cactorium/ism-915mhz-transceiver/sim/README.md

Basically a lot of simulations used for designing different stages of the discrete transceiver.
It's an agglomeration of Qucs simulations with Jupyter notebooks, so you'll want those two programs to examine this stuff
