cactorium/ism-915mhz-transceiver/pcb/discrete/discrete-rf-board/pdfs/discrete-rf-board.pdf

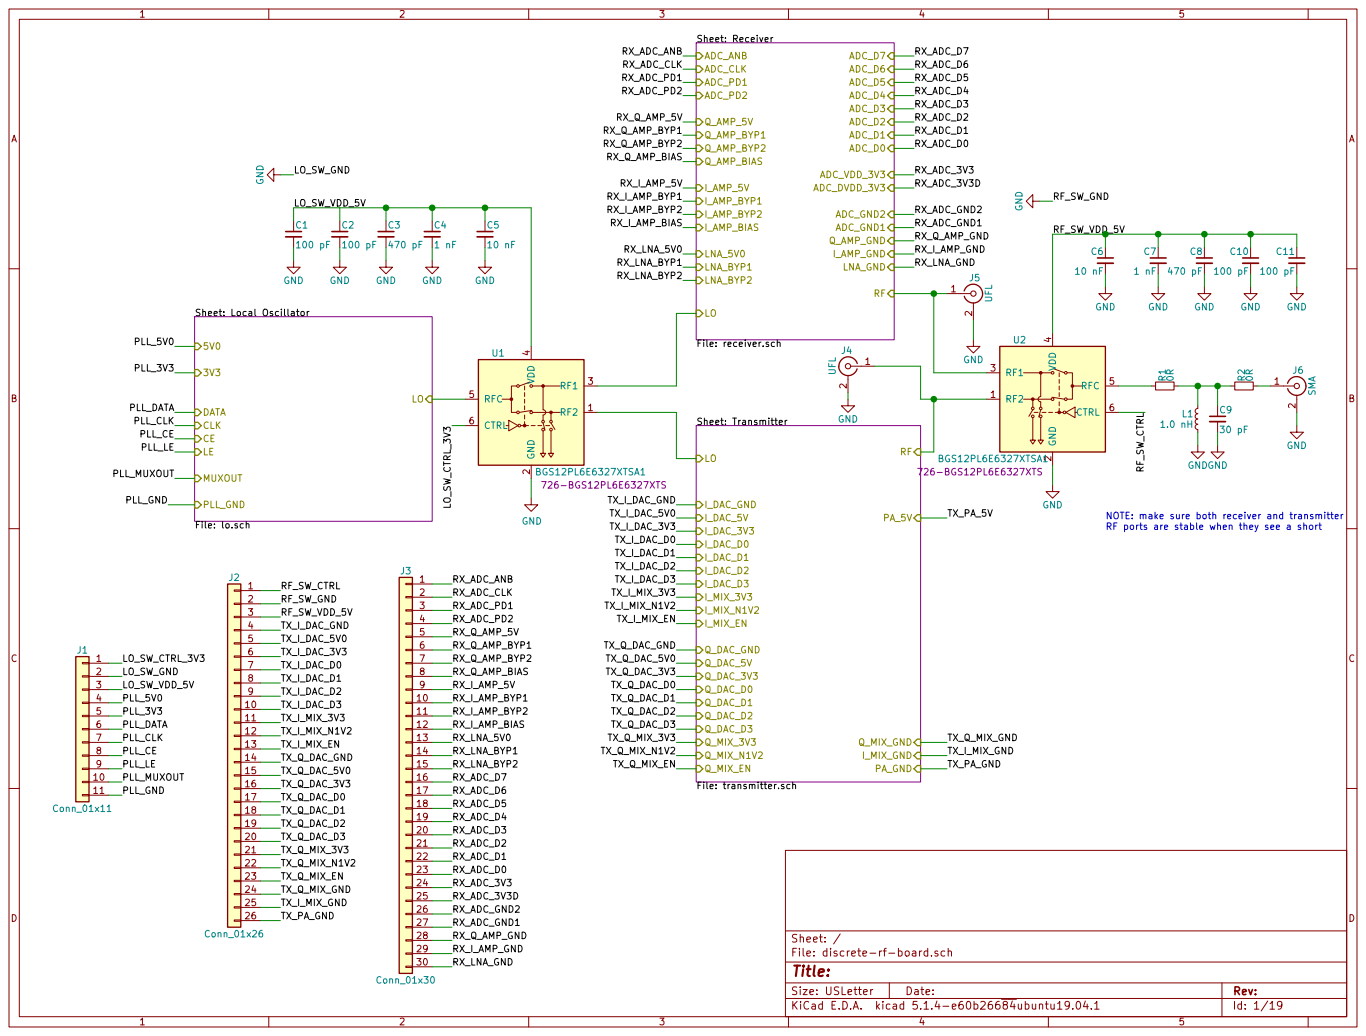
[picture p1: page 1]

Sheet: Local Oscillator File: lo.sch CLK CEMUXOUT

Id: 1/19 Title: File: discrete-rf-board.sch Sheet: /

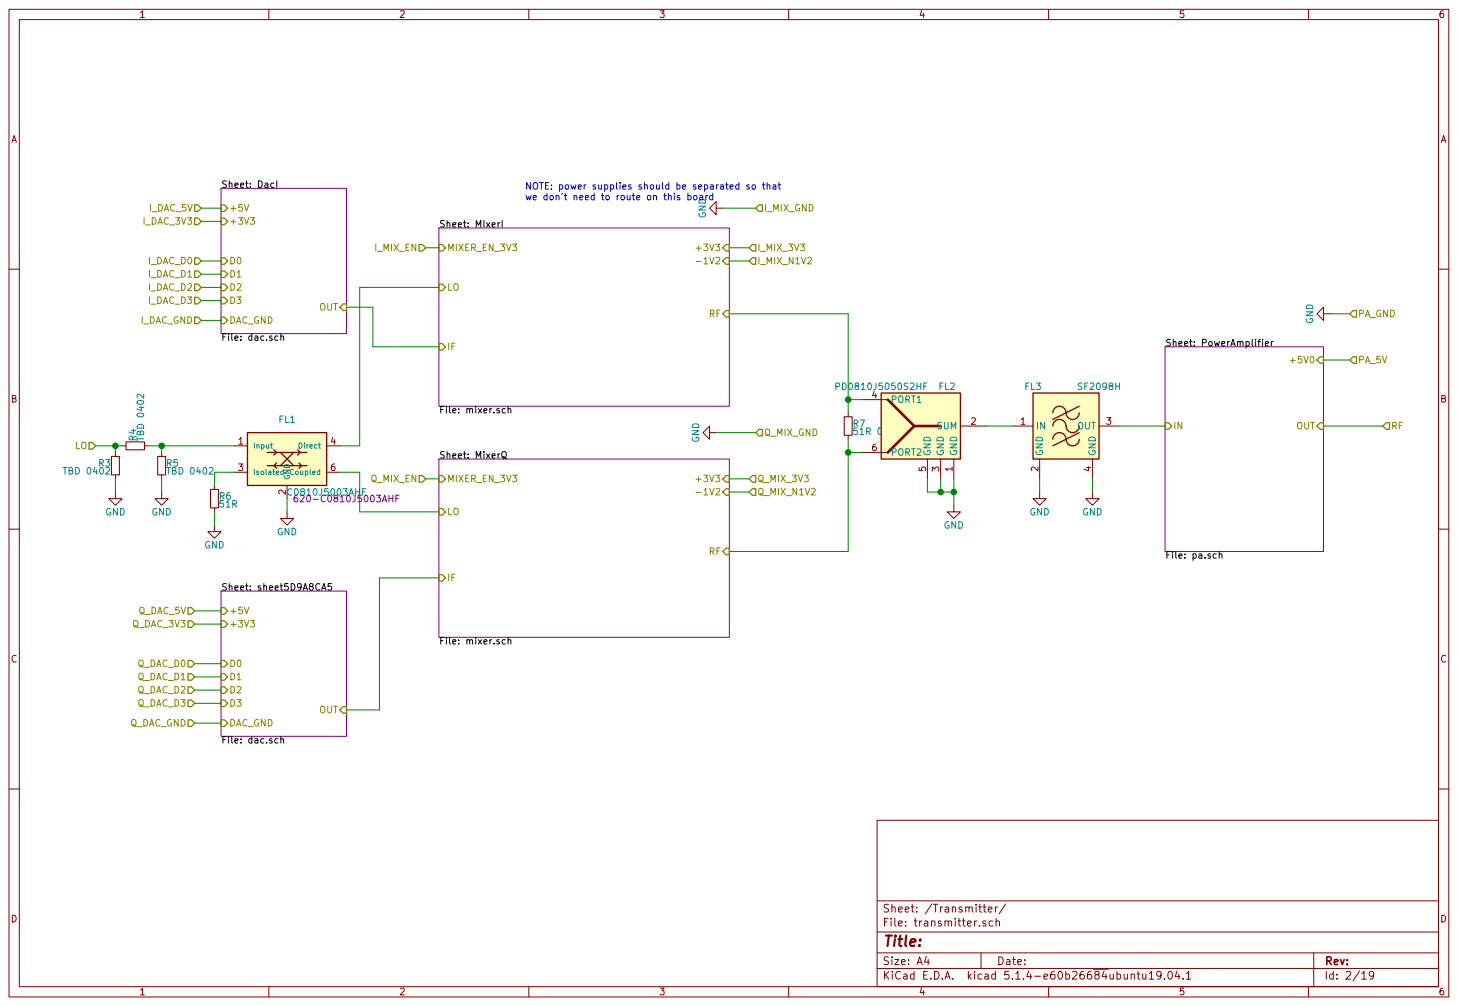
[picture p2: page 2]

+5V0 Sheet: MIxerI File: mixer.sch
I_MIX_EN Q_MIX_EN

Id: 2/19 Title: File: transmitter.sch Sheet: /Transmitter/

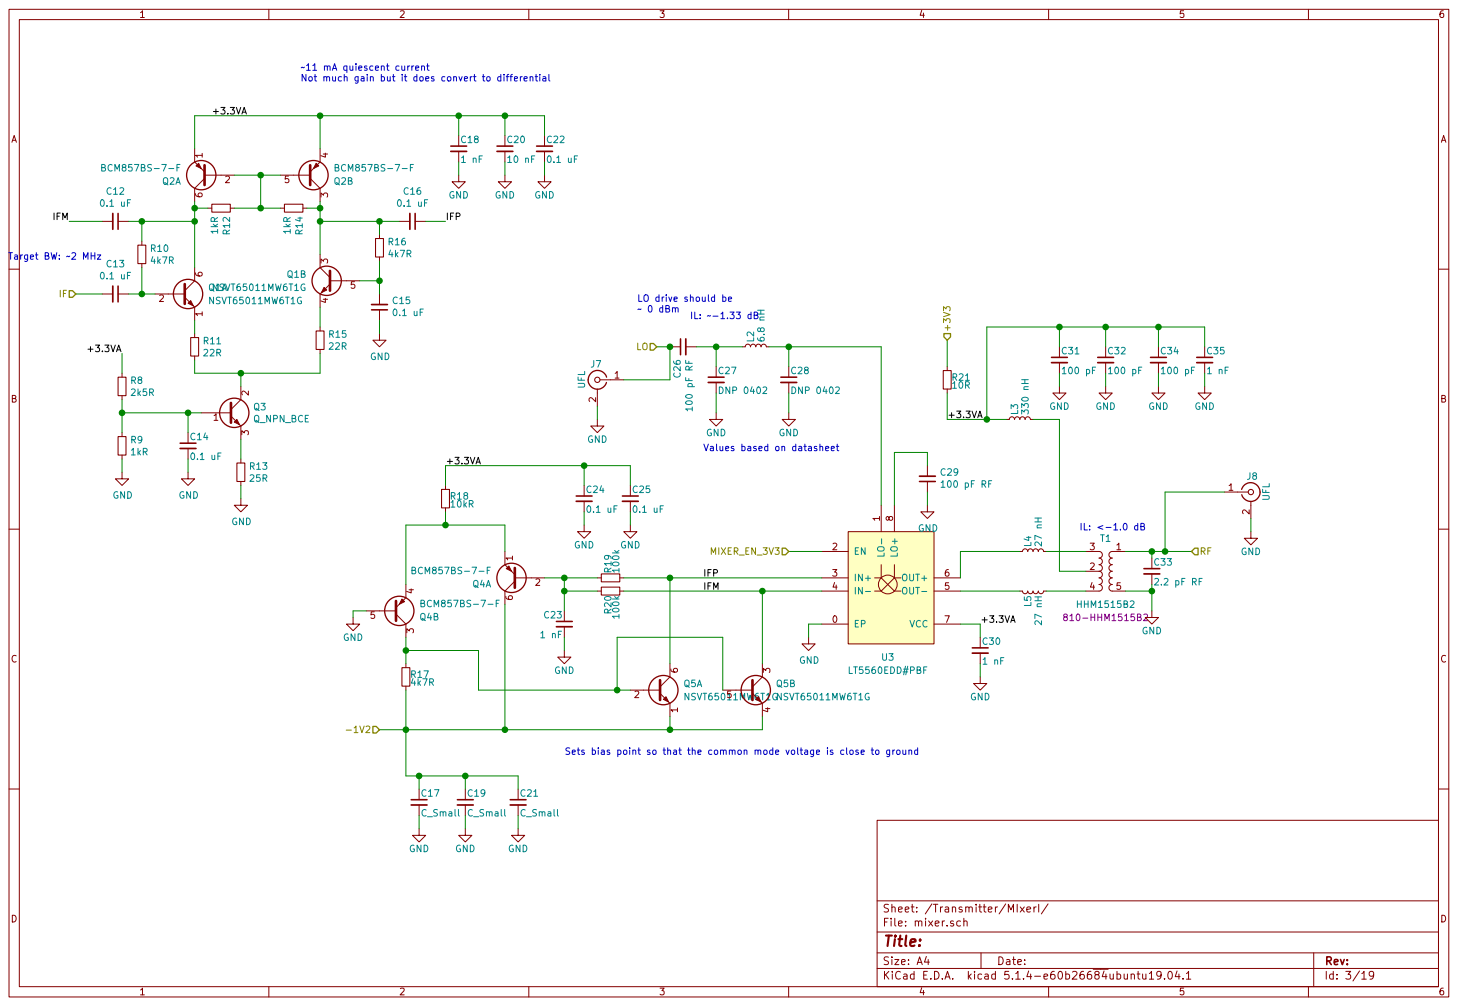
[picture p3: page 3]

LO drive should be

2 J8 UFL EP 0 LO- 1 EN 2

Sets bias point so that the common mode voltage is close to ground

Id: 3/19 Title: File: mixer.sch Sheet: /Transmitter/MIxerI/

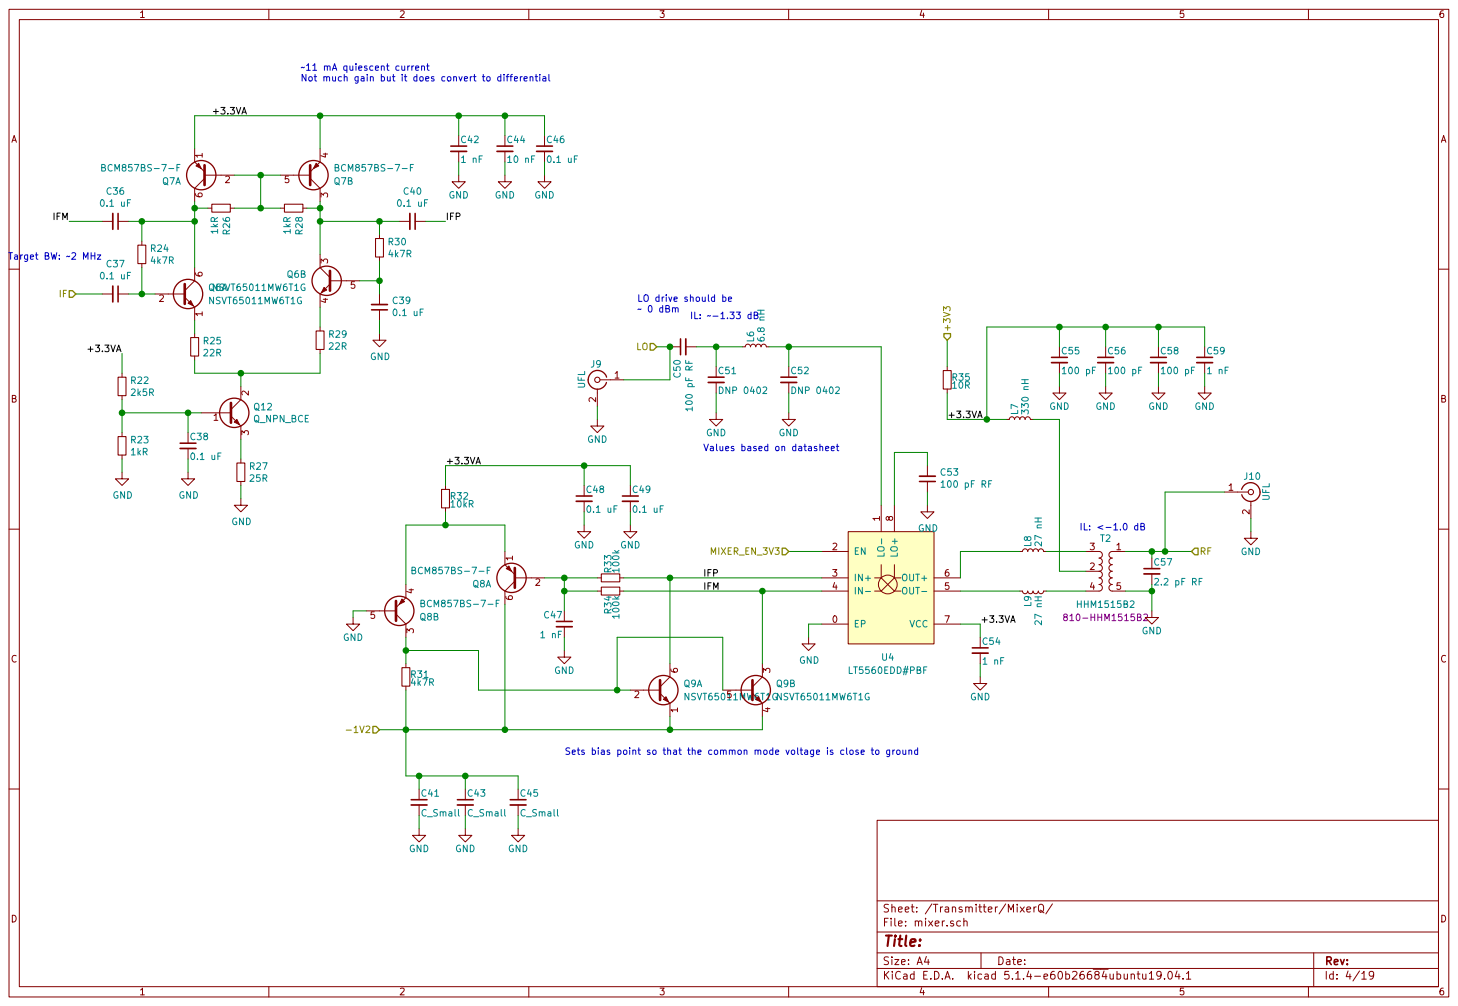
[picture p4: page 4]

LO drive should be

Sets bias point so that the common mode voltage is close to ground

Id: 4/19 Title: File: mixer.sch Sheet: /Transmitter/MixerQ/

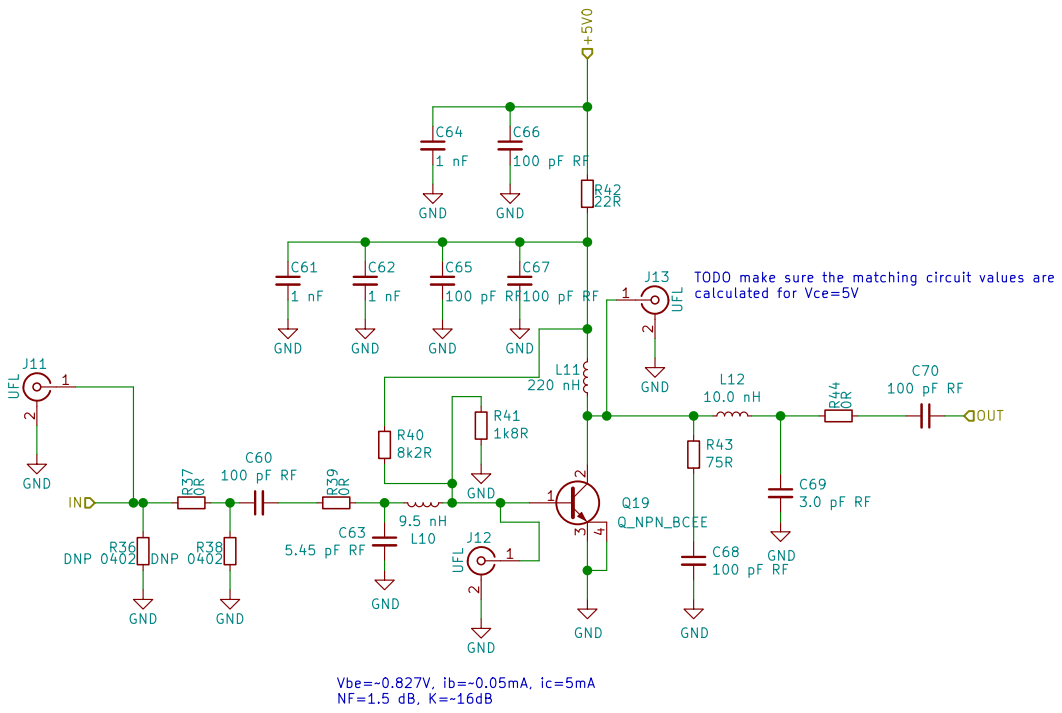
[picture p5: page 5]

J13 UFL
TODO make sure the matching circuit values are
calculated for Vce=5V

Vbe=0.827V, ib=0.05mA, ic=5mA NF=1.5 dB, K=16dB

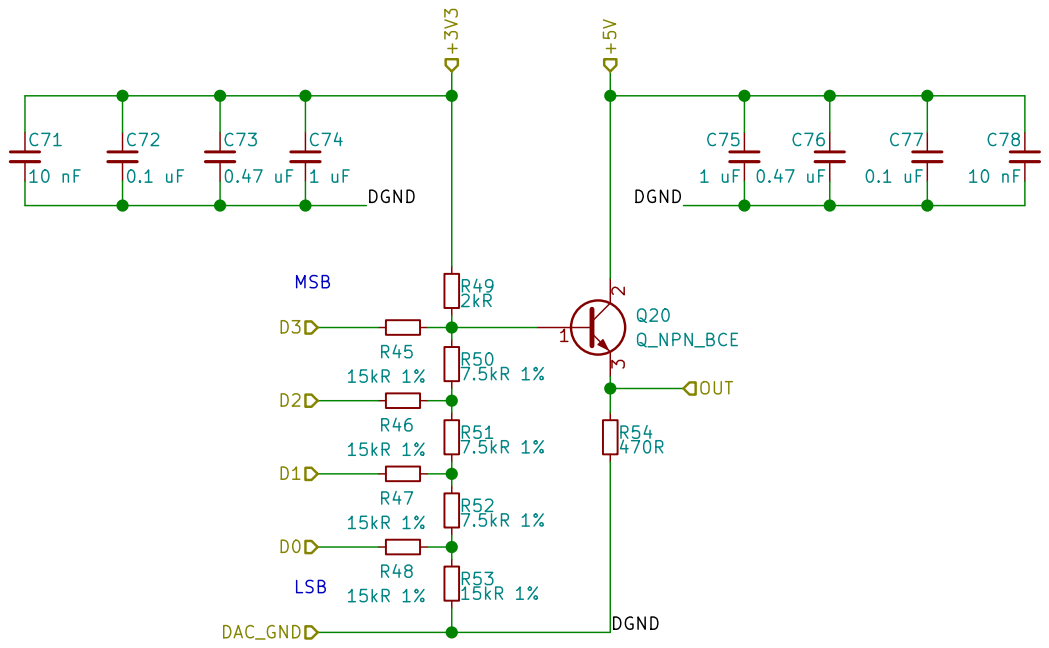
[picture p6: page 6]

Id: 6/19 Title: File: dac.sch Sheet: /Transmitter/DacI/

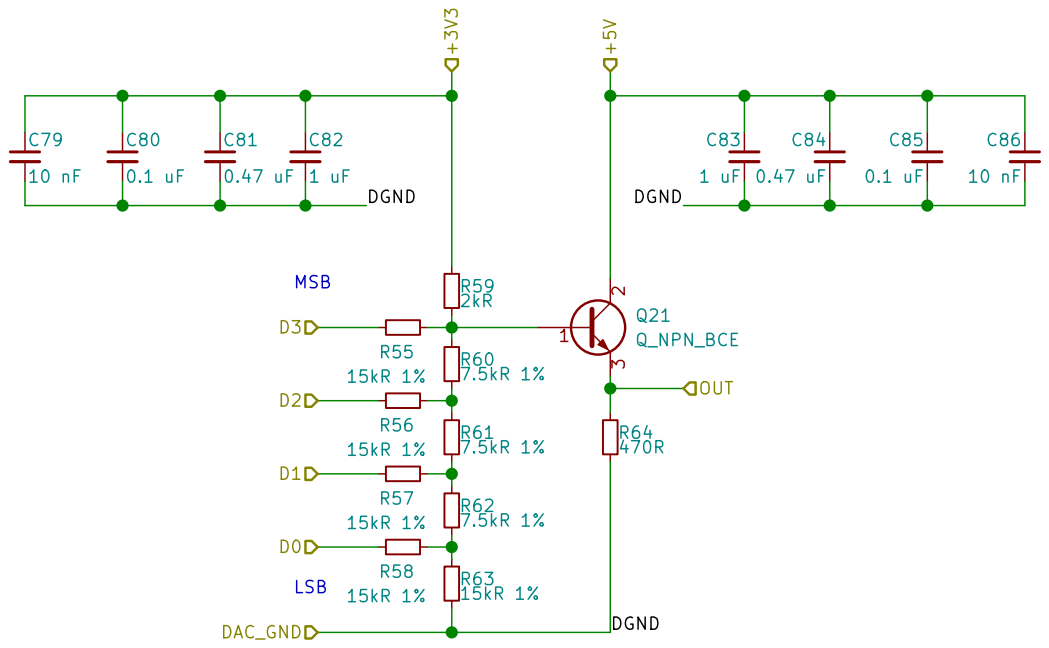
[picture p7: page 7]

Id: 7/19 Title: File: dac.sch Sheet: /Transmitter/sheet5D9A8CA5/

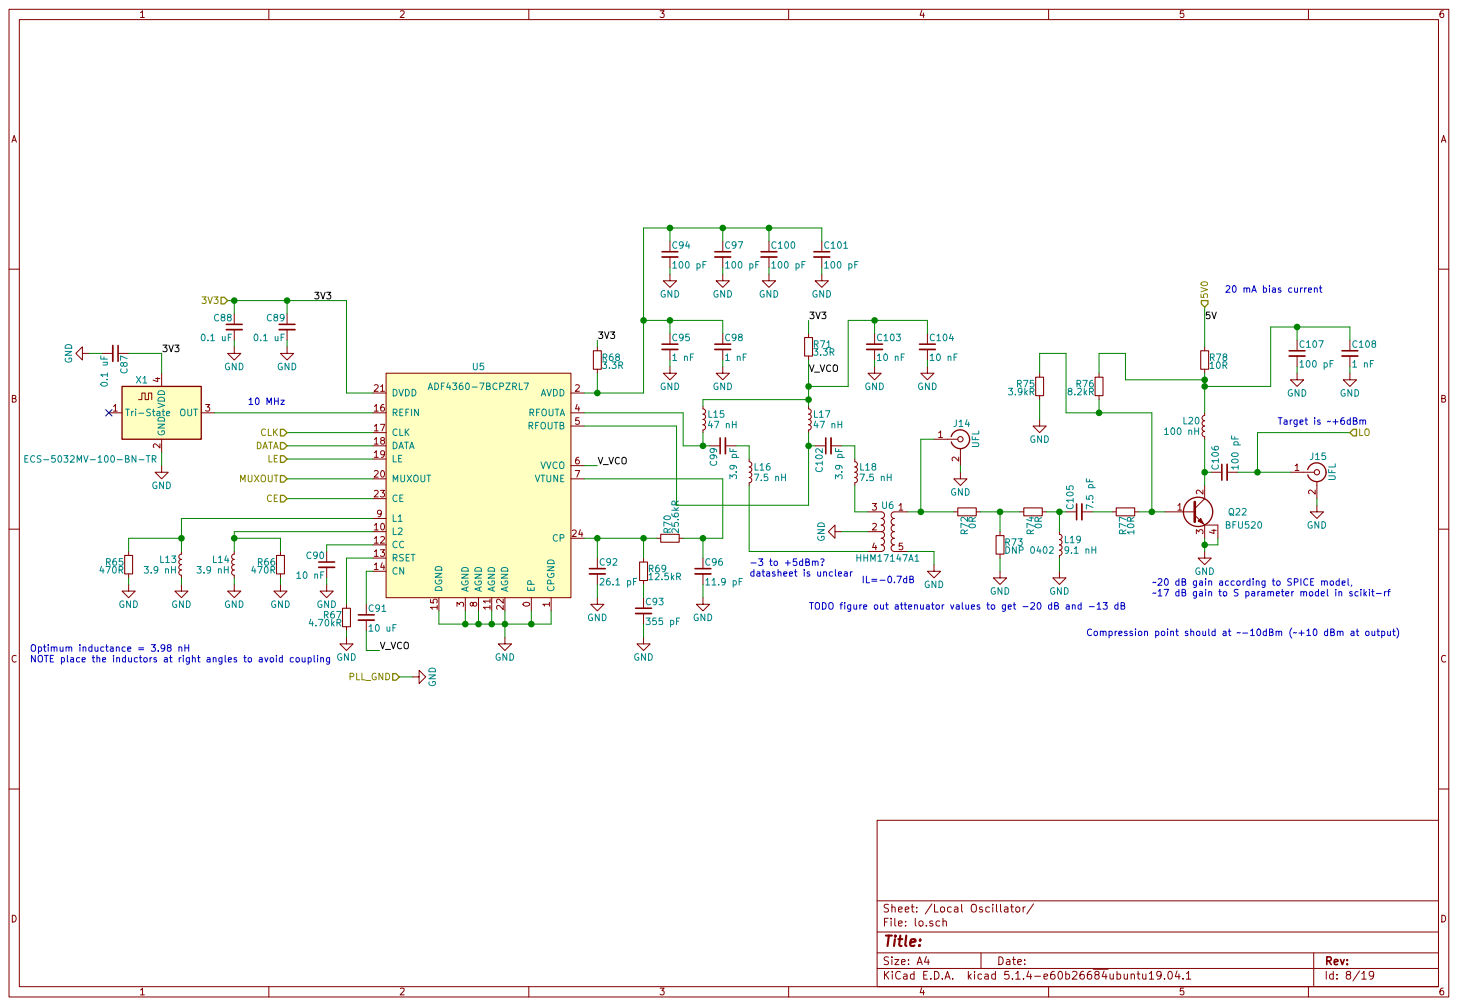
[picture p8: page 8]

17 dB gain to S parameter model in scikit-rf 20 mA bias current Compression point should at -10dBm (+10 dBm at output)

2 OUT VDD 3 X1 4 ECS-5032MV-100-BN-TR GND C87 0.1 uFGND GND GND

3 RFOUTA 4 RFOUTB 5 VVCO 6 VTUNE 7 AGND

J15 UFL GND GND EP

Optimum inductance = 3.98 nH
NOTE place the inductors at right angles to avoid coupling

Id: 8/19 Title: File: lo.sch Sheet: /Local Oscillator/

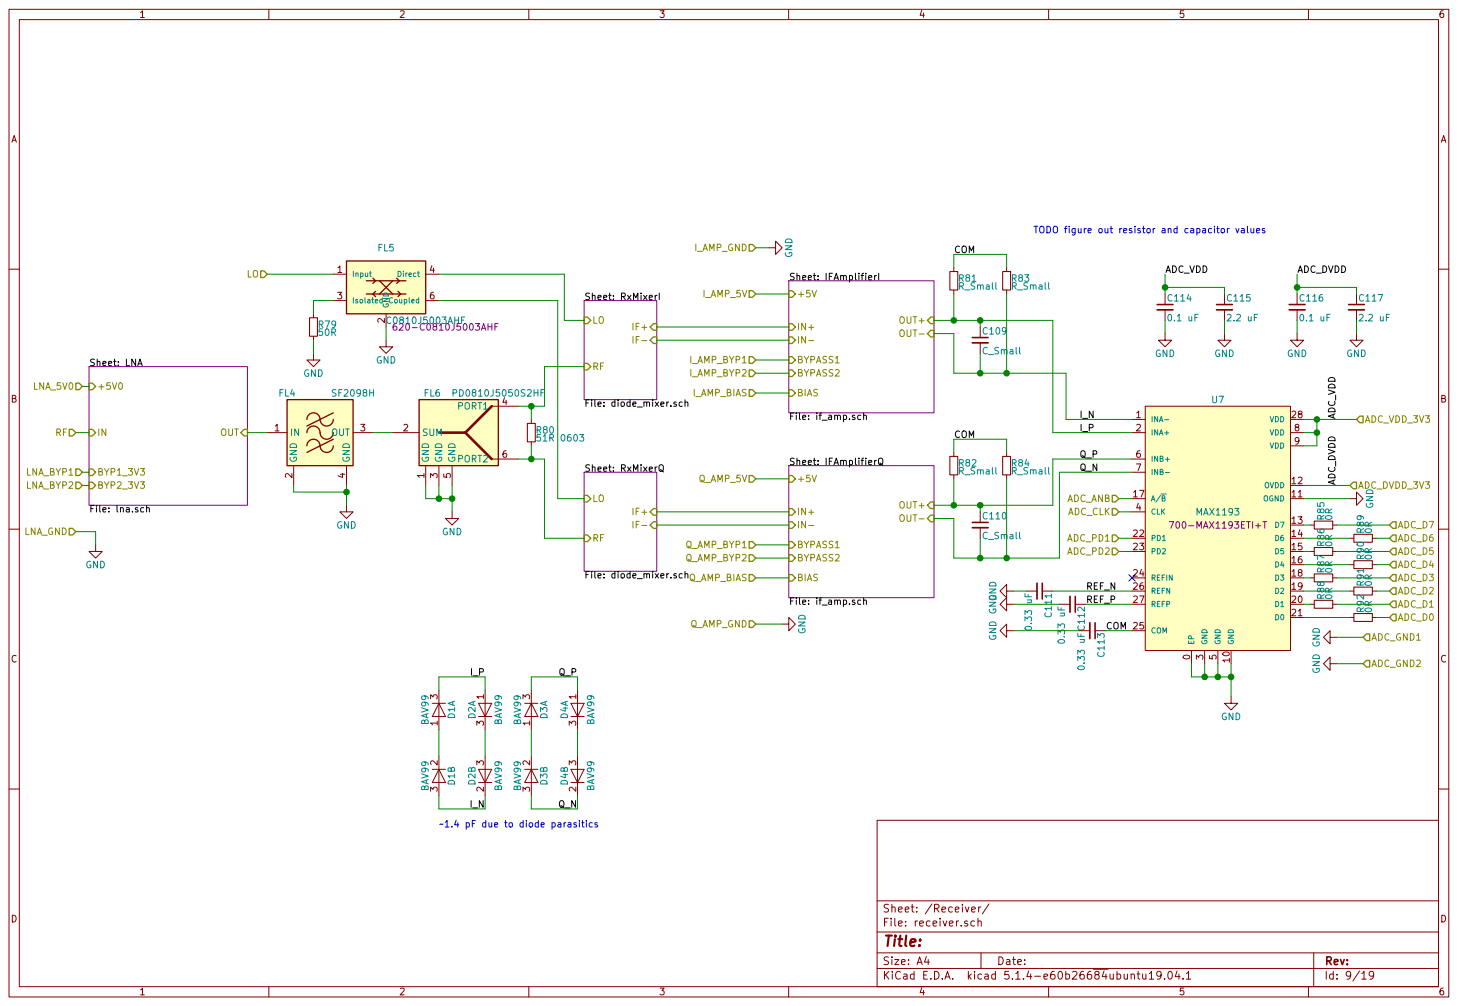
[picture p9: page 9]

TODO figure out resistor and capacitor values

2 3 D4B BAV99 GND GND GND GND

1.4 pF due to diode parasitics

Id: 9/19 Title: File: receiver.sch Sheet: /Receiver/

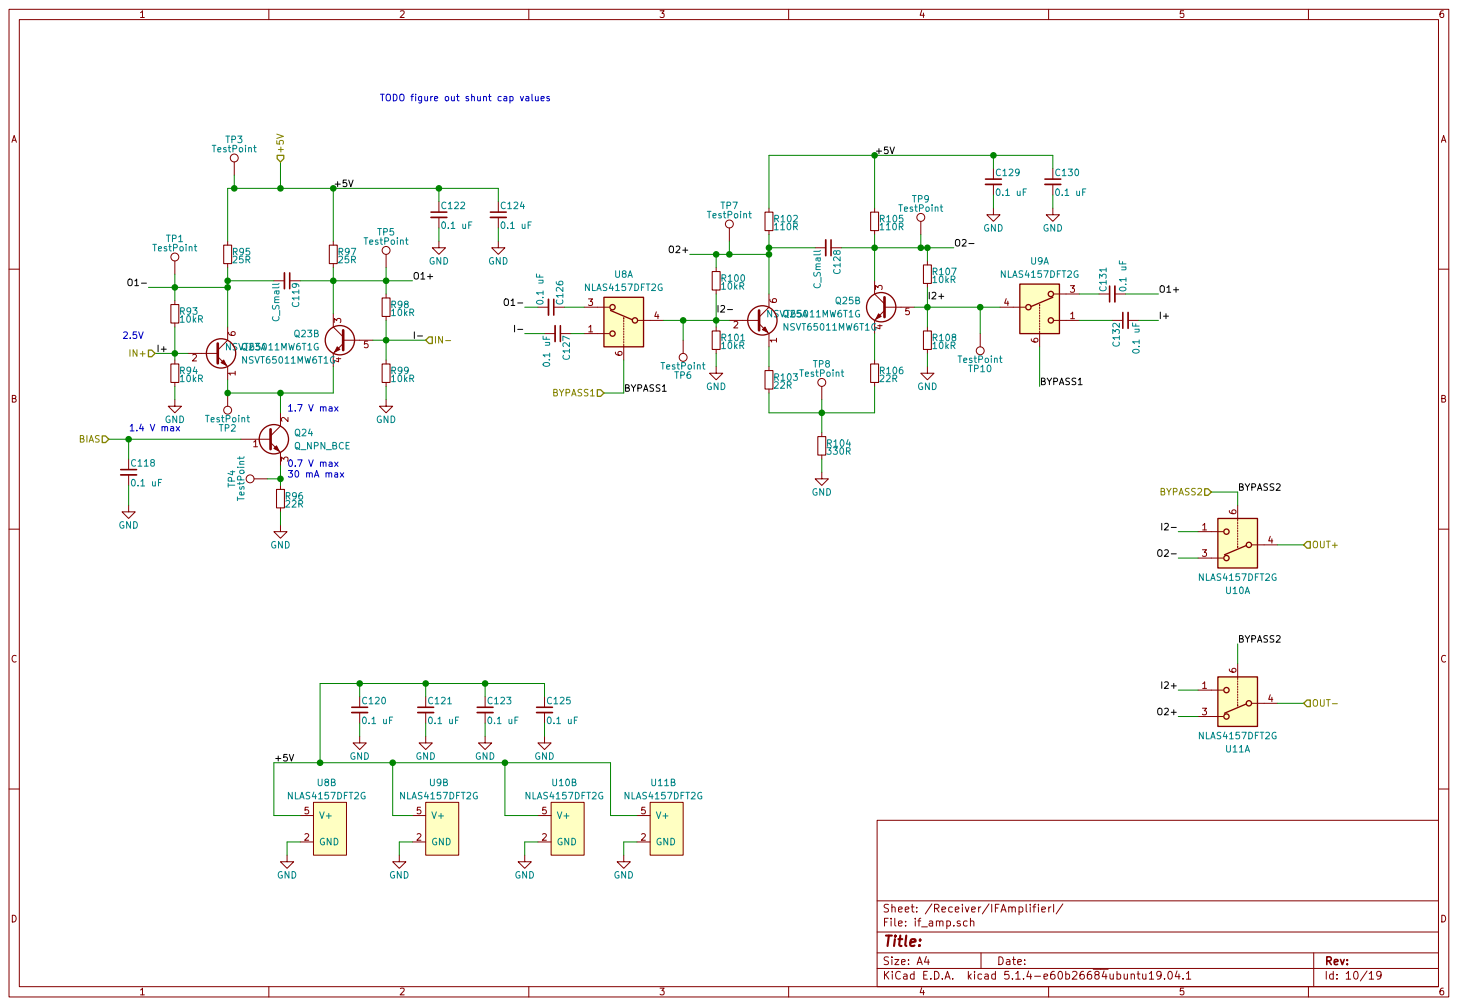
[picture p10: page 10]

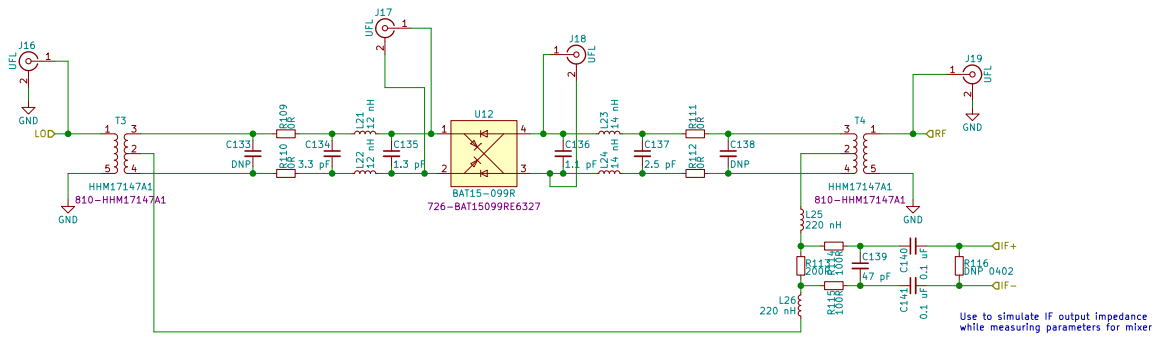
[picture p11: page 11]

IF- Use to simulate IF output impedance

while measuring parameters for mixer

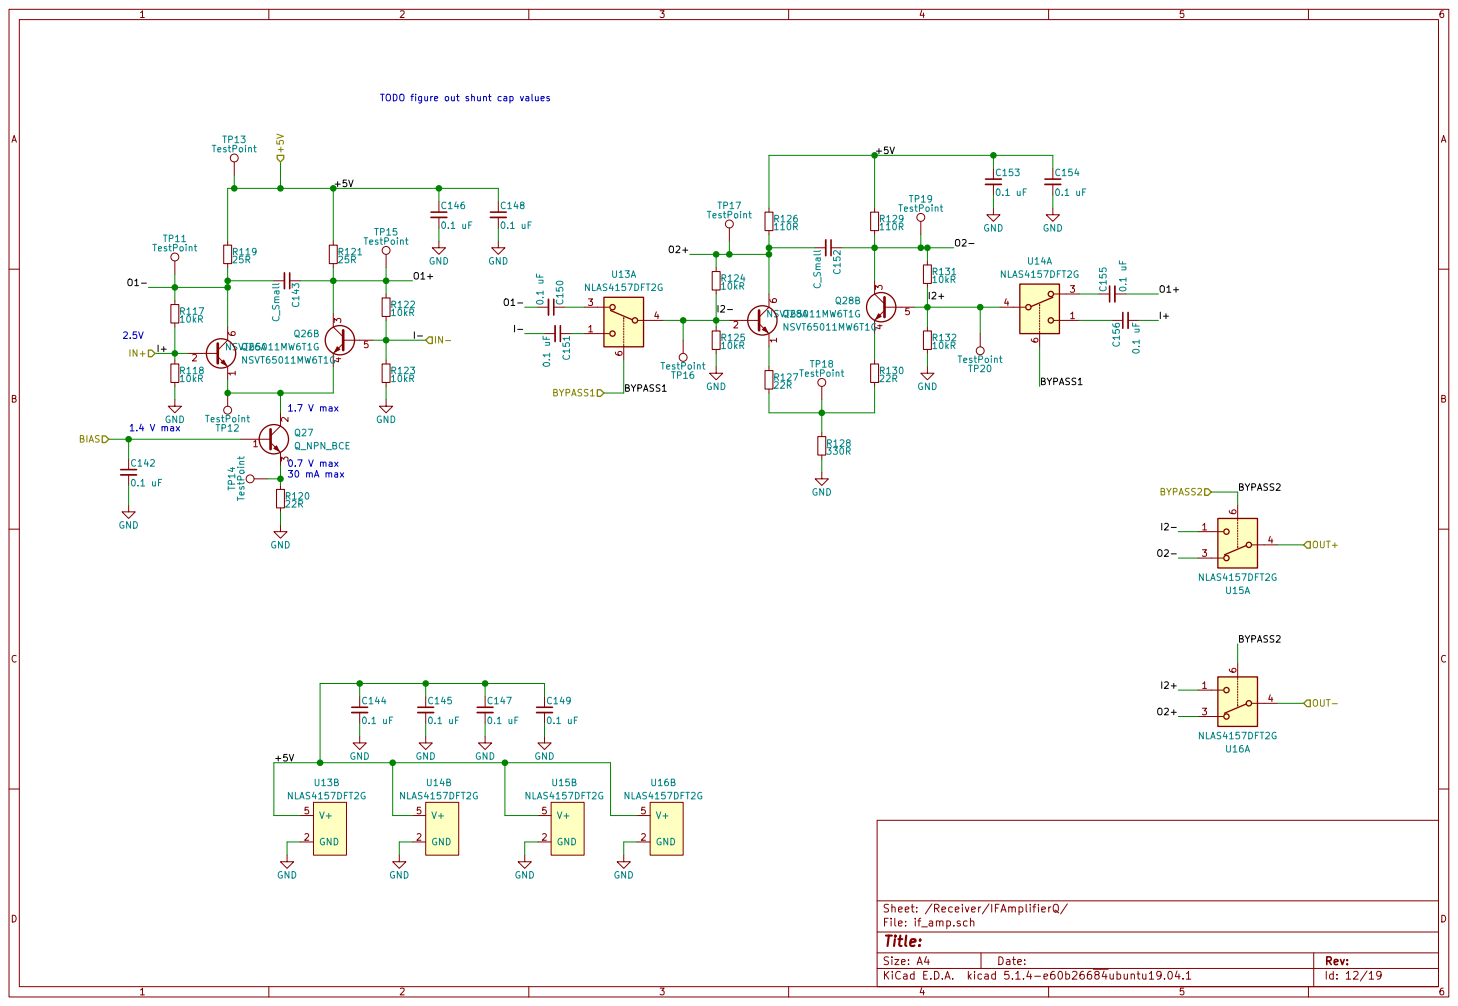
[picture p12: page 12]

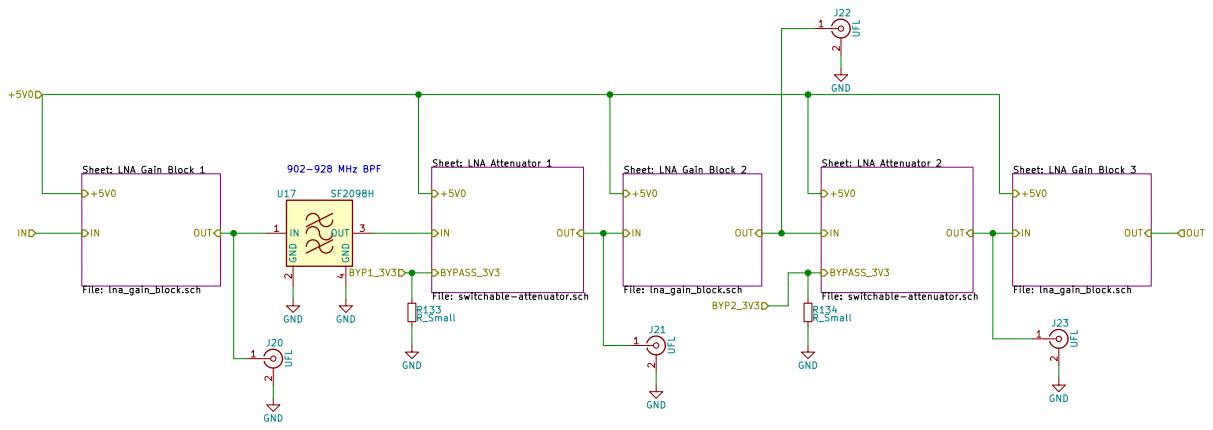
[picture p13: page 13]

+5V0 Sheet: LNA Gain Block 1 File: lna_gain_block.sch

Sheet: LNA Gain Block 3 File: lna_gain_block.sch

Id: 13/19 Title: File: lna.sch Sheet: /Receiver/LNA/

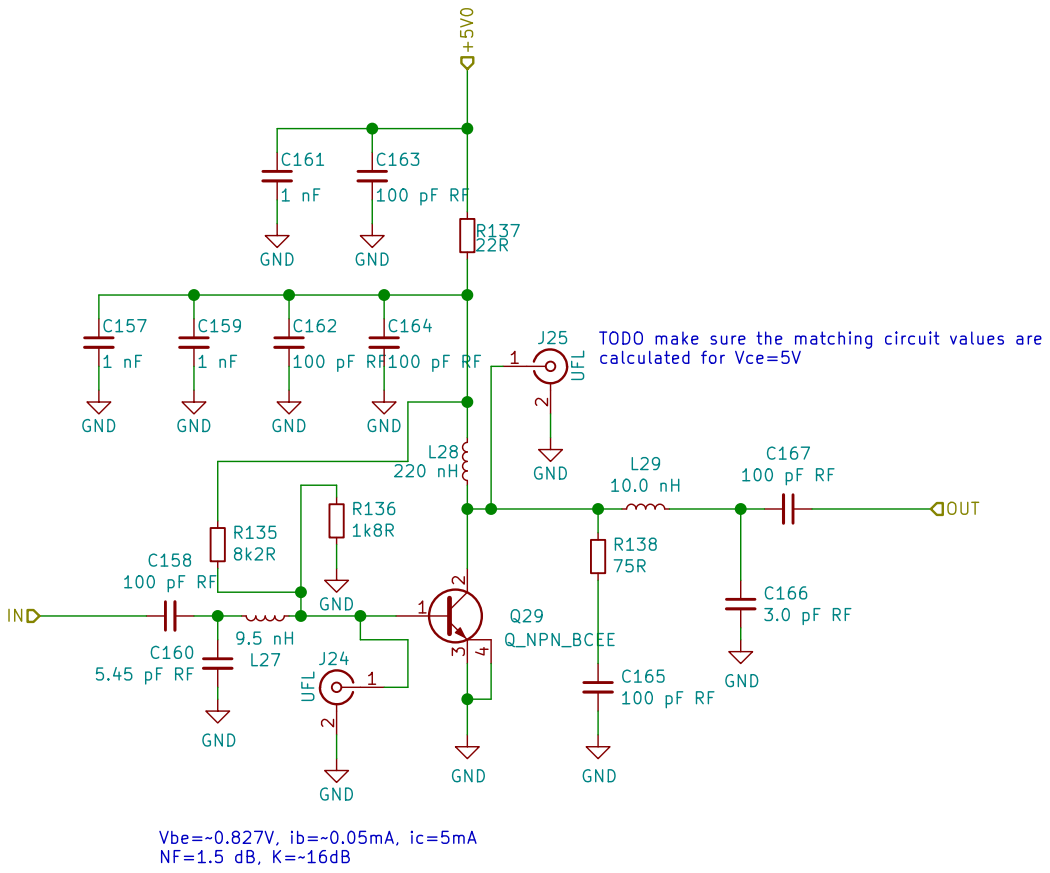
[picture p14: page 14]

TODO make sure the matching circuit values are
calculated for Vce=5V

File: lna_gain_block.sch Sheet: /Receiver/LNA/LNA Gain Block 2/
Id: 14/19 Title:

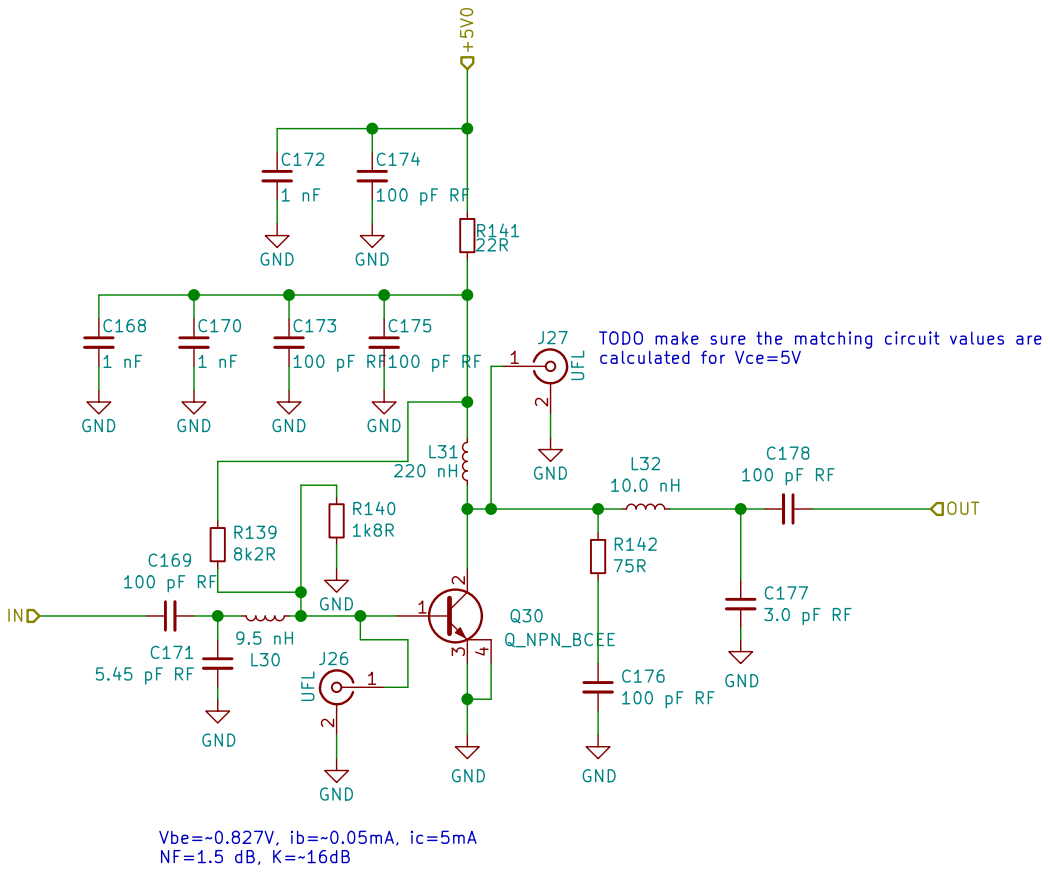
[picture p15: page 15]

TODO make sure the matching circuit values are
calculated for Vce=5V

File: lna_gain_block.sch Sheet: /Receiver/LNA/LNA Gain Block 3/
Id: 15/19 Title:

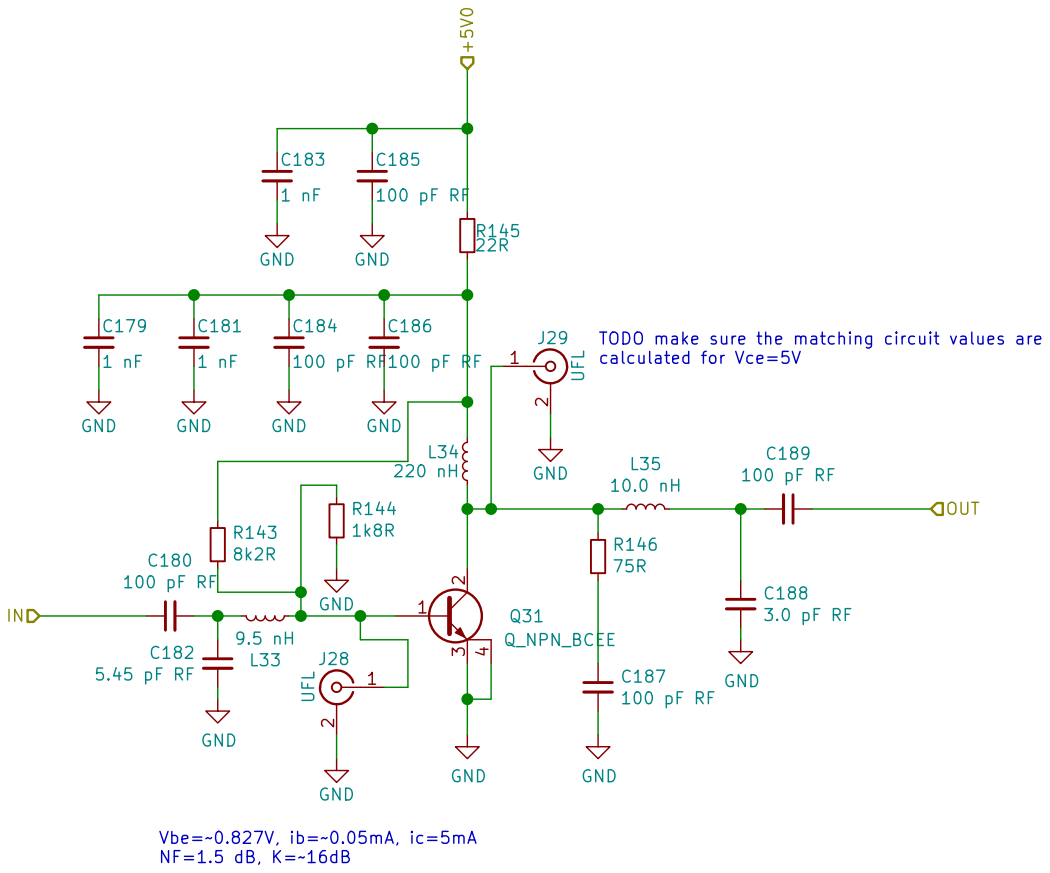
[picture p16: page 16]

TODO make sure the matching circuit values are
calculated for Vce=5V

File: lna_gain_block.sch Sheet: /Receiver/LNA/LNA Gain Block 1/
Id: 16/19 Title:

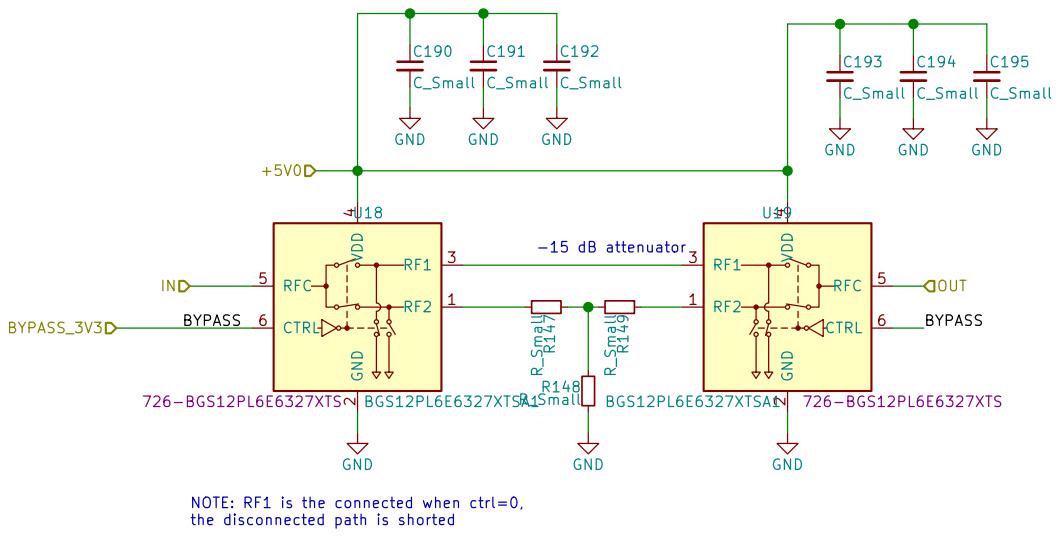
[picture p17: page 17]

-15 dB attenuator NOTE: RF1 is the connected when ctrl=0,

the disconnected path is shorted

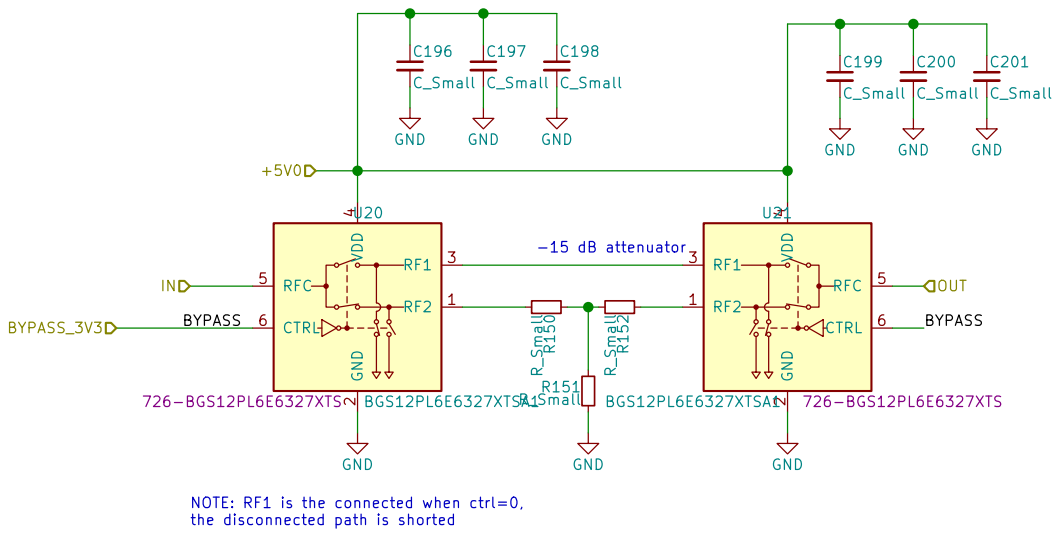
[picture p18: page 18]

-15 dB attenuator NOTE: RF1 is the connected when ctrl=0,

the disconnected path is shorted

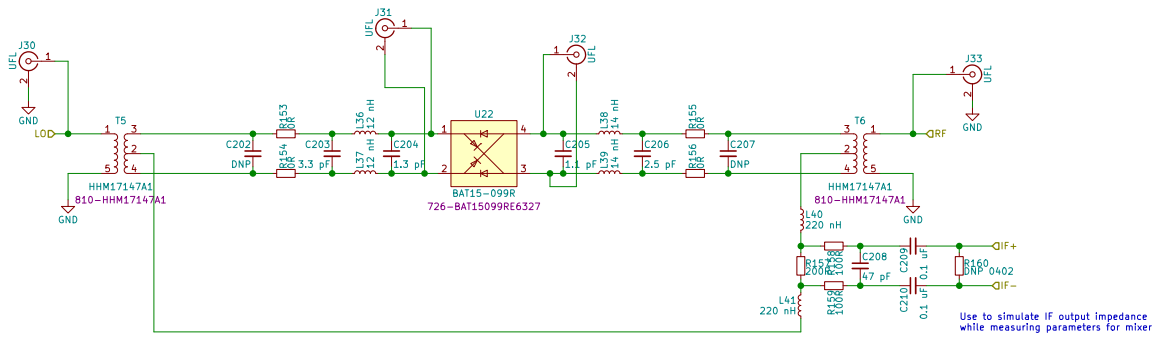
[picture p19: page 19]

J31 UFL
File: diode_mixer.sch Sheet: /Receiver/RxMixerI/ R156 0R

IF- Use to simulate IF output impedance

while measuring parameters for mixer
