cactorium/ism-915mhz-transceiver/pcb/discrete/test-mixer/test-mixer.kicad_pcb

## KiCad design pcb/discrete/test-mixer/test-mixer.kicad_pcb (2019-12-20)

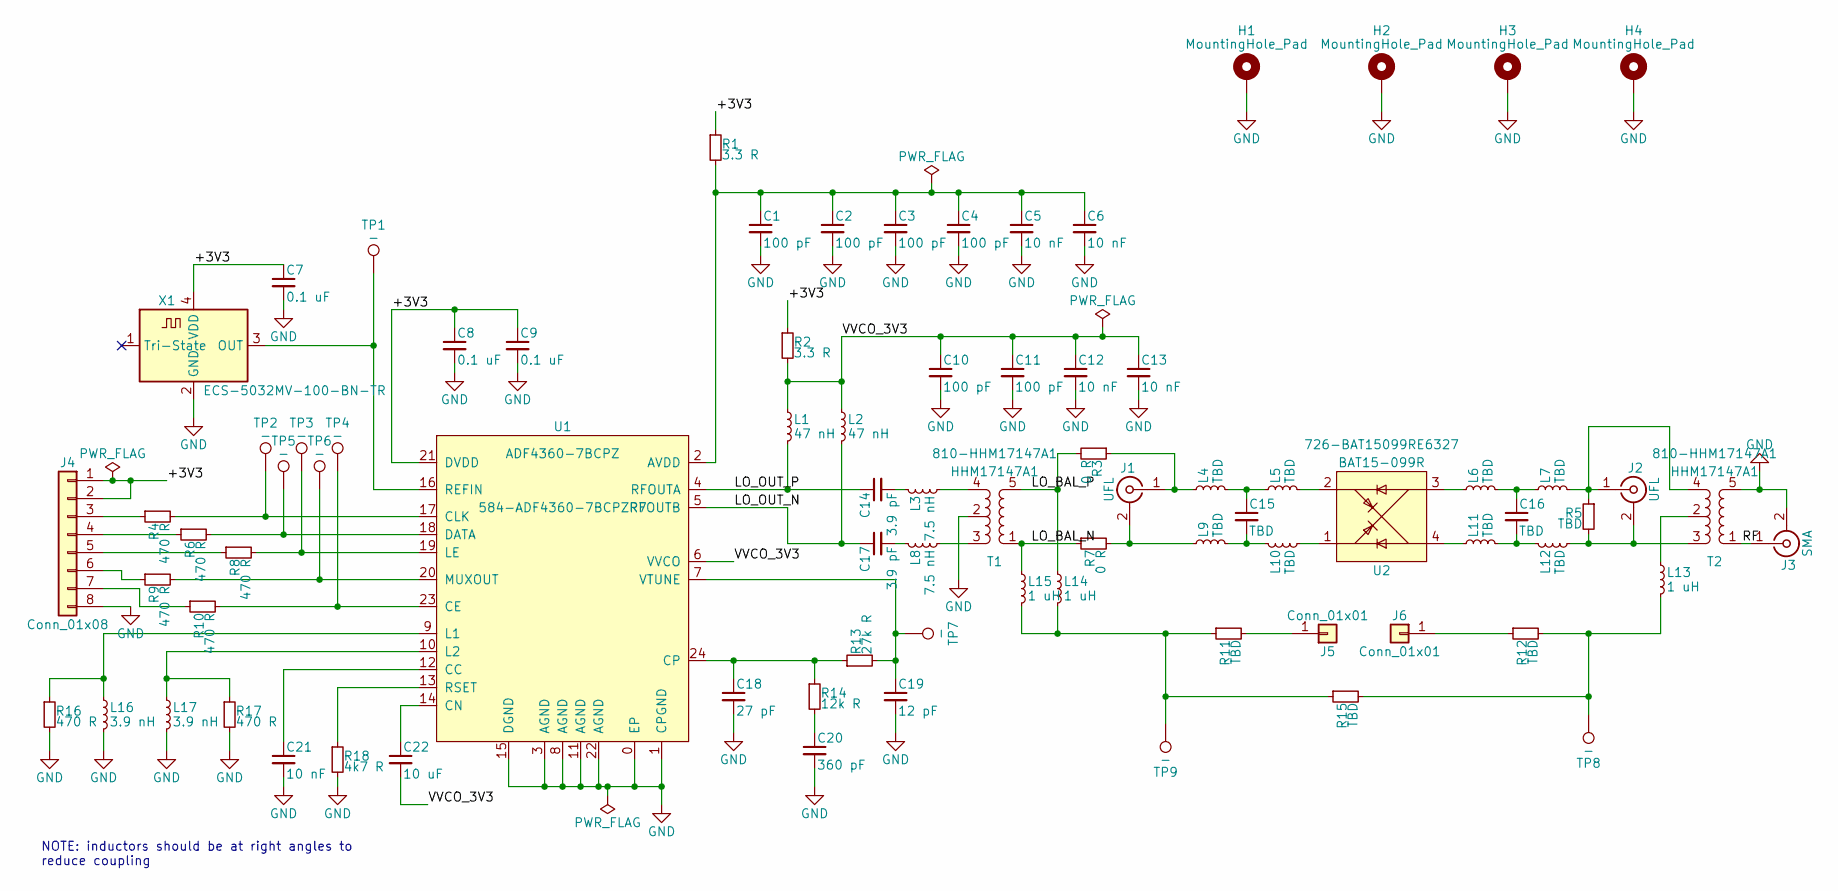
[picture p20: schematic test-mixer.sch]

Parts:
C1, C2, C3, C4, C10, C11: 100 pF; C_0603_1608Metric_Pad1.05x0.95mm_HandSolder; Mouser 791-RF18N101J500CT
C5, C6, C12, C13, C21: 10 nF; C_0402_1005Metric; Mouser 80-C0402C103K4R7411
C7, C8, C9: 0.1 uF; C_0402_1005Metric; Mouser 80-C0402C104M4P
C14, C17: 3.9 pF; C_0402_1005Metric; Mouser 81-GJM1555C1H3R9CB1D
C15, C16: TBD; C_0402_1005Metric; Mouser NoPart
C18: 27 pF; C_0603_1608Metric_Pad1.05x0.95mm_HandSolder; Mouser 80-C0603C270K5G
C19: 12 pF; C_0805_2012Metric_Pad1.15x1.40mm_HandSolder; Mouser 80-C0805C120J1HACTU
C20: 360 pF; C_0402_1005Metric; Mouser 963-UMK105CH361JVHF
C22: 10 uF; C_0805_2012Metric_Pad1.15x1.40mm_HandSolder; Mouser 81-GRM21BC81C106KE5L
H1, H2, H3, H4: MountingHole_Pad; MountingHole_3.2mm_M3_DIN965; Mouser NoPart
J1, J2: UFL; 2337019-1; Mouser 571-2337019-1
J3: SMA; 142-0701-801-with-taper; Mouser 530-142-0701-801
J4: Conn_01x08; PinHeader_1x08_P2.54mm_Vertical; Mouser NoPart
J5, J6: Conn_01x01; PinSocket_1x01_P2.54mm_Vertical; Mouser NoPart
L1, L2: 47 nH; C_0402_1005Metric; Mouser 81-LQG15HZ47NJ02D
L3, L8: 7.5 nH; C_0402_1005Metric; Mouser 81-LQG15HN7N5J02D
L4, L5, L6, L7, L9, L10, L11, L12: TBD; C_0402_1005Metric; Mouser NoPart
L13, L14, L15: 1 uH; C_0402_1005Metric; Mouser 815-AIML-0402-1R0KT
L16, L17: 3.9 nH; C_0402_1005Metric; Mouser 81-LQG15HS3N9C02D
R1, R2: 3.3 R; R_0603_1608Metric_Pad1.05x0.95mm_HandSolder; Mouser 652-CR0603-J/-3R3ELF
R3, R7: 0 R; R_0402_1005Metric; Mouser 71-CRCW04020000Z0EDC
R4, R6, R8, R9, R10, R16, R17: 470 R; R_0402_1005Metric; Mouser 603-RC0402JR-13470RL
R5, R11, R12, R15: TBD; R_0402_1005Metric; Mouser NoPart
R13: 27k R; R_0603_1608Metric_Pad1.05x0.95mm_HandSolder; Mouser 603-RC0603FR-1027KL
R14: 12k R; R_0603_1608Metric_Pad1.05x0.95mm_HandSolder; Mouser 652-CR0603FX-1202ELF
R18: 4k7 R; R_0402_1005Metric; Mouser 603-AC0402FR-134K7L
T1, T2: HHM17147A1; TDK_HHM17147A1; Mouser 810-HHM17147A1
TP1, TP2, TP3, TP4, TP5, TP6, TP7, TP8, TP9: -; TestPoint_Pad_D1.0mm; Mouser NoPart
U1: ADF4360-7BCPZ; Analog_CP-24-14; Mouser 584-ADF4360-7BCPZR7
U2: BAT15-099R; NXP_SOT143B; Mouser 726-BAT15099RE6327
X1: ECS-5032MV-100-BN-TR; Oscillator_SMD_SeikoEpson_SG8002LB-4Pin_5.0x3.2mm_HandSolde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; Mouser 520-5032MV-100-BNT

Connections:
/+3V3: C7.1, C8.1, C9.1, J4.1, J4.2, R1.1, R2.1, U1.21 (DVDD), X1.4 (VDD)
/LO_BAL_N: L15.1, R7.1, T1.1 (SINGLE)
/LO_BAL_P: L14.1, R3.2, T1.5 (GND)
/LO_OUT_N: C17.1, L2.2, U1.5 (RFOUTB)
/LO_OUT_P: C14.1, L1.2, U1.4 (RFOUTA)
/RF: J3.1 (In), T2.1 (SINGLE)
/VVCO_3V3: C10.1, C11.1, C12.1, C13.1, C22.2, L1.1, L2.1, R2.2, U1.6 (VVCO)
GND: C1.2, C2.2, C3.2, C4.2, C5.2, C6.2, C7.2, C8.2, C9.2, C10.2, C11.2, C12.2, C13.2, C18.2, C19.2, C20.2, C21.2, H1.1, H2.1, H3.1, H4.1, J3.2 (Ext), J4.8, L16.2, L17.2, R16.2, R17.2, R18.2, T1.2 (COMMON), T2.5 (GND), U1.0 (EP), U1.1 (CPGND), U1.3 (AGND), U1.8 (AGND), U1.11 (AGND), U1.15 (DGND), U1.22 (AGND), X1.2 (GND)
unnamed: C1.1, C2.1, C3.1, C4.1, C5.1, C6.1, R1.2, U1.2 (AVDD)
unnamed: C14.2, L3.1
unnamed: C15.1, L4.2, L5.1
unnamed: C15.2, L9.2, L10.1
unnamed: C16.1, L6.2, L7.1
unnamed: C16.2, L11.2, L12.1
unnamed: C17.2, L8.1
unnamed: C18.1, R13.1, R14.1, U1.24 (CP)
unnamed: C19.1, R13.2, TP7.1, U1.7 (VTUNE)
unnamed: C20.1, R14.2
unnamed: C21.1, U1.12 (CC)
unnamed: C22.1, U1.14 (CN)
unnamed: J1.1 (In), L4.1, R3.1
unnamed: J1.2 (Ext), L9.1, R7.2
unnamed: J2.1 (In), L7.2, R5.1, T2.4 (-)
unnamed: J2.2 (Ext), L12.2, R5.2, T2.3 (+)
unnamed: J4.3, R4.1
unnamed: J4.4, R6.1
unnamed: J4.5, R8.1
unnamed: J4.6, R9.1
unnamed: J4.7, R10.1
unnamed: J5.1, R11.2
unnamed: J6.1, R12.1
unnamed: L3.2, T1.4 (-)
unnamed: L5.2, U2.2 (B)
unnamed: L6.1, U2.3 (C)
unnamed: L8.2, T1.3 (+)
unnamed: L10.2, U2.1 (A)
unnamed: L11.1, U2.4 (D)
unnamed: L13.1, T2.2 (COMMON)
unnamed: L13.2, R12.2, R15.2, TP8.1
unnamed: L14.2, L15.2, R11.1, R15.1, TP9.1
unnamed: L16.1, R16.1, U1.9 (L1)
unnamed: L17.1, R17.1, U1.10 (L2)
unnamed: R4.2, TP2.1, U1.17 (CLK)
unnamed: R6.2, TP5.1, U1.18 (DATA)
unnamed: R8.2, TP3.1, U1.19 (LE)
unnamed: R9.2, TP6.1, U1.20 (MUXOUT)
unnamed: R10.2, TP4.1, U1.23 (CE)
unnamed: R18.1, U1.13 (RSET)
unnamed: TP1.1, U1.16 (REFIN), X1.3 (OUT)

Notes on the sheet:
NOTE: inductors should be at right angles to reduce coupling

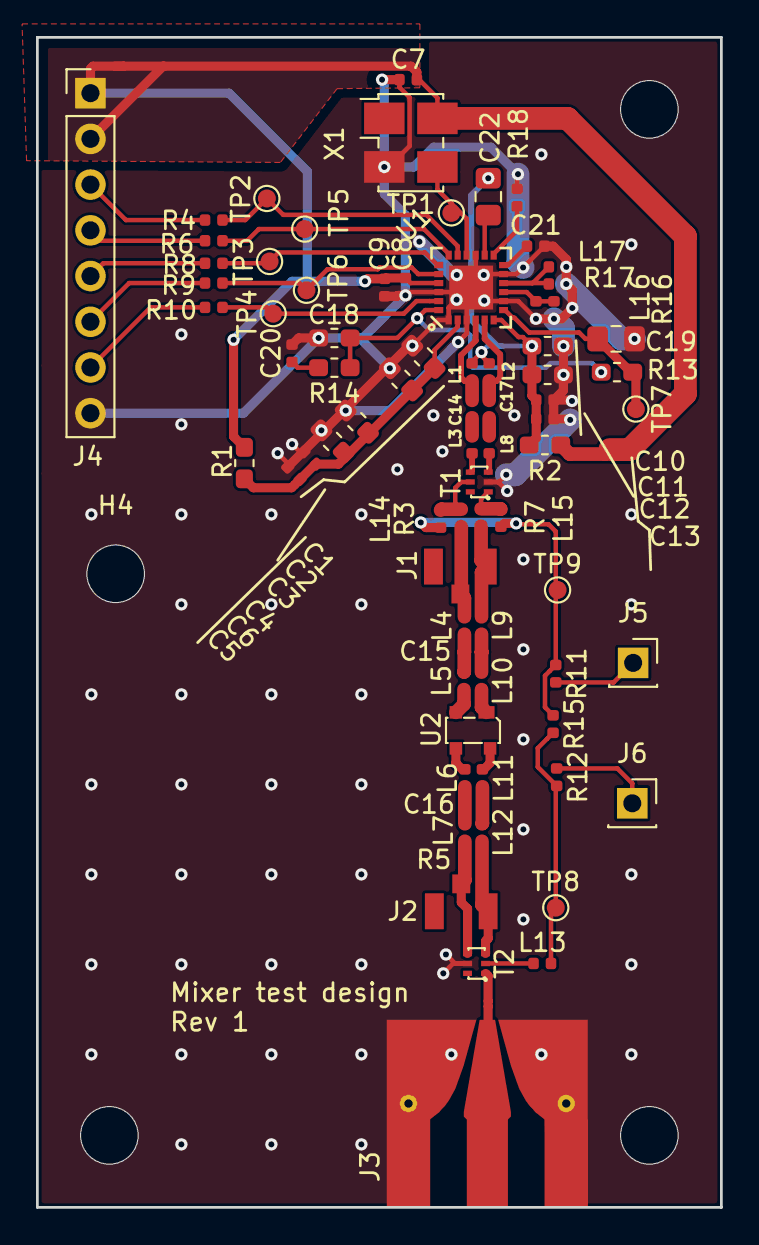
[picture p21: board test-mixer.kicad_pcb from above]

Board: 2 copper layers, 38.0 x 65.0 mm, 81 parts (0 on the bottom side), 49 nets.
