cactorium/ism-915mhz-transceiver/(commit log)

2019-03-19 Work on power amplifier design; got the matching networks set up, and they seem to work, a part from being almost marginally unstable
2019-04-13 Start work on schematics
    [discrete-rf-board.kicad_pcb, discrete-rf-board.sch, lo.sch, receiver.sch, transmitter.sch]
2019-04-13 Start work on power amplifier stage and LO amplifier
    [bfu520_lo_amplifier.sch, bfu_pa_1stage.sch]
2019-04-13 LO amplifier simulation is pretty close to done; it seems like the BFU520XR will just barely do the job; compression point is >6 dBm, amplifier seems sufficiently stable
    [bfu520_lo_amplifier.sch]
2019-04-13 Finish first draft of LO amplifier
    [bfu520_lo_amplifier.sch, discrete-rf-board.sch, lo.sch, receiver.sch, transmitter.sch]
2019-04-14 Match mixer LO input and RF output to 50 ohms
    [bfu520_mixer.sch, mixer_large_signal.sch, mixer_match.sch]
2019-04-15 Finish active mixer simulation; it looks good!
    [bfu520_mixer.sch, discrete-rf-board.sch, lo.sch, mixer.sch, mixer_large_signal_if.sch, mixer_match.sch, receiver.sch, transmitter.sch]
2019-04-17 Finish diode mixer simulations and capture in schematic
    [bat15_mixer.sch, diode_mixer.sch, discrete-rf-board.sch, lo.sch, mixer.sch, receiver.sch, transmitter.sch]
2019-04-18 Fix scattering parameter phase calculations
    [bat15_mixer.sch]
2019-04-29 Capture IF amplifier stages and work on LNA stages
    [bat15_mixer_upconverter.sch, diode_mixer.sch, discrete-rf-board.sch, if_amp.sch, lo.sch, mixer.sch, receiver.sch, transmitter.sch]
2019-05-01 Picked matched NPNs for IF amplifier stages
    [if_amp.sch]
2019-05-17 Almost working LNA first and second stage; need to figure out why the second stage isn't conjugatively matching correctly
2019-05-17 Second stage almost working, still off for some reason
2019-05-18 Lower bias current to 5 mA
2019-06-19 Save changes while moving over to the new laptop
    [bat15_mixer_upconverter.sch, diode_mixer.sch, discrete-rf-board.sch, if_amp.sch, lna.sch, lo.sch, mixer.sch, receiver.sch]
2019-06-19 Fix symbol tables I guess
    [diode_mixer.sch, discrete-rf-board.sch, mixer.sch]
2019-06-26 Finish TX mixer; added IF buffer
    [dc_active_bias_test.sch, lo.sch, mixer.sch]
2019-06-28 Update so that it works witth the current scikit-rf master; TODO figure out how to version scikit-rf
2019-06-30 Work on LNA staging, attenuator design, various fixes elsewhere
    [diode_mixer.sch, discrete-rf-board.sch, if_amp.sch, lna.sch, lna_gain_block.sch, lo.sch, mixer.sch, receiver.sch]
2019-07-12 Work on simulations a litte more.. looks like testing in-situ is honestly the best option
    [if_diff_long_tail.sch, if_diff_long_tail_active.sch, if_diff_long_tail_active_bias_active_load.sch, lna_stage.sch]
2019-09-13 Source hybrid quadrature coupler, add front end LC filter
    [PowerAmplifier.sch, dac.sch, pa.sch]
2019-09-13 Design DAC/ADC stages, pass out all control signals to top sheet
    [dac.sch, diode_mixer.sch, discrete-rf-board.sch, if_amp.sch, lna.sch, lna_gain_block.sch, lo.sch, mixer.sch]
2019-09-16 Wire out all control signals to connectors TODO PLL charge pump loop, bypass caps in attenuator circuit, antialiasing filter for ADC frontend
    [dac.sch, diode_mixer.sch, discrete-rf-board.sch, if_amp.sch, lna.sch, lna_gain_block.sch, lo.sch, mixer.sch]
2019-09-17 Start work in footprinting everything
    [diode_mixer.sch, discrete-rf-board.sch, if_amp.sch, lna_gain_block.sch, lo.sch, mixer.sch, switchable-attenuator.sch]
2019-09-17 Fix some parts
    [lna.sch, lna_gain_block.sch, switchable-attenuator.sch]
2019-09-18 The footprintening continues
    [dac.sch, diode_mixer.sch, discrete-rf-board.sch, if_amp.sch, lna_gain_block.sch, lo.sch, mixer.sch, receiver.sch]
2019-09-18 Add matching PNP/NPN transistor pairs, fix pin numbering for BFU520R transistors TODO fix biasing on power stage, source last NPN transistor, autofill and start sourcing passives
    [dac.sch, diode_mixer.sch, discrete-rf-board.sch, if_amp.sch, lna.sch, lna_gain_block.sch, lo.sch, mixer.sch]
2019-09-19 All component values set (TODO change transistor gain stages to match values from experimentation
    [dac.sch, diode_mixer.sch, if_amp.sch, lna_gain_block.sch, lo.sch, mixer.sch, pa.sch, receiver.sch]
2019-09-19 Autofill; lots left to do
    [PowerAmplifier.sch, diode_mixer.sch, discrete-rf-board.sch, if_amp.sch, lna_gain_block.sch, lo.sch, mixer.sch, pa.sch]
2019-09-19 Autofill all; TODO improve formatting on autofill_all output
    [lna.sch]
2019-09-20 Footprint some stuff
    [dac.sch, diode_mixer.sch, discrete-rf-board.sch, if_amp.sch, lna.sch, lna_gain_block.sch, lo.sch, mixer.sch]
2019-09-20 Add more footprints, saving before autofill
    [dac.sch, diode_mixer.sch, discrete-rf-board.sch, if_amp.sch, lna_gain_block.sch, lo.sch, mixer.sch, pa.sch]
2019-09-23 Reannotate everything; I'm trying to cut down the number of components
    [dac.sch, diode_mixer.sch, discrete-rf-board.sch, if_amp.sch, lna.sch, lna_gain_block.sch, lo.sch, mixer.sch]
2019-09-24 Footprint a lot of stuff; save before autofill
    [dac.sch, diode_mixer.sch, discrete-rf-board.sch, if_amp.sch, lna_gain_block.sch, lo.sch, mixer.sch, pa.sch]
2019-09-24 Add in a couple more components, save before autofill
    [dac.sch, diode_mixer.sch, discrete-rf-board.sch, lna_gain_block.sch, lo.sch, mixer.sch, pa.sch, receiver.sch]
2019-09-24 Footprint more stuff
    [dac.sch, diode_mixer.sch, lo.sch, mixer.sch, pa.sch, receiver.sch, switchable-attenuator.sch, transmitter.sch]
2019-09-25 Start work on simpler RF board using less discrete components so it's not a giant mess
    [integrated-rf-board.kicad_pcb, integrated-rf-board.sch]
2019-10-01 Fix mixer simulation and start work on test mixer PCB
    [bat15_mixer_upconverter.sch, test-mixer.kicad_pcb, test-mixer.sch]
2019-10-03 Footprint everything(?)
    [test-mixer.sch]
2019-10-03 Move test mixer files down a directory
    [test-mixer.kicad_pcb, test-mixer.sch]
2019-10-03 Add in some more footprints before autofill
    [test-mixer.sch]
2019-10-03 Autofill finish
    [test-mixer.sch]
2019-10-03 Add mounting holes, fix DRC errors
    [test-mixer.sch]
2019-10-05 Finish layout
    [test-mixer.kicad_pcb, test-mixer.sch]
2019-12-19 Generate Gerbers and BOM
    [test-mixer-B_Cu.gbl, test-mixer-B_Fab.gbr, test-mixer-B_Mask.gbs, test-mixer-B_Paste.gbp, test-mixer-B_SilkS.gbo, test-mixer-Edge_Cuts.gm1, test-mixer-F_Cu.gtl, test-mixer-F_Fab.gbr]
2019-12-20 Regenerate Gerbers, just to be safe
    [test-mixer-B_Cu.gbl, test-mixer-B_Fab.gbr, test-mixer-B_Mask.gbs, test-mixer-B_Paste.gbp, test-mixer-B_SilkS.gbo, test-mixer-Edge_Cuts.gm1, test-mixer-F_Cu.gtl, test-mixer-F_Fab.gbr]
2019-12-20 Regenerate in old format
    [test-mixer-B_Cu.gbl, test-mixer-B_Fab.gbr, test-mixer-B_Mask.gbs, test-mixer-B_Paste.gbp, test-mixer-B_SilkS.gbo, test-mixer-Edge_Cuts.gm1, test-mixer-F_Cu.gtl, test-mixer-F_Fab.gbr]
